Nicolai-Electronics/i2c-vfd-hardware/README.md

# I2C controlled HCS-12SS59T VFD

This repository contains the hardware desgin files for the I2C controlled NE-HCS12SS59T-R01 Vacuum Fluorescent Display board.

## License

Copyright 2024 Nicolai Electronics

This hardware design may be used under the terms of the [CERN-OHL-P](LICENSE) license.
