Nicolai-Electronics/i2c-vfd-hardware/release/schematic.pdf

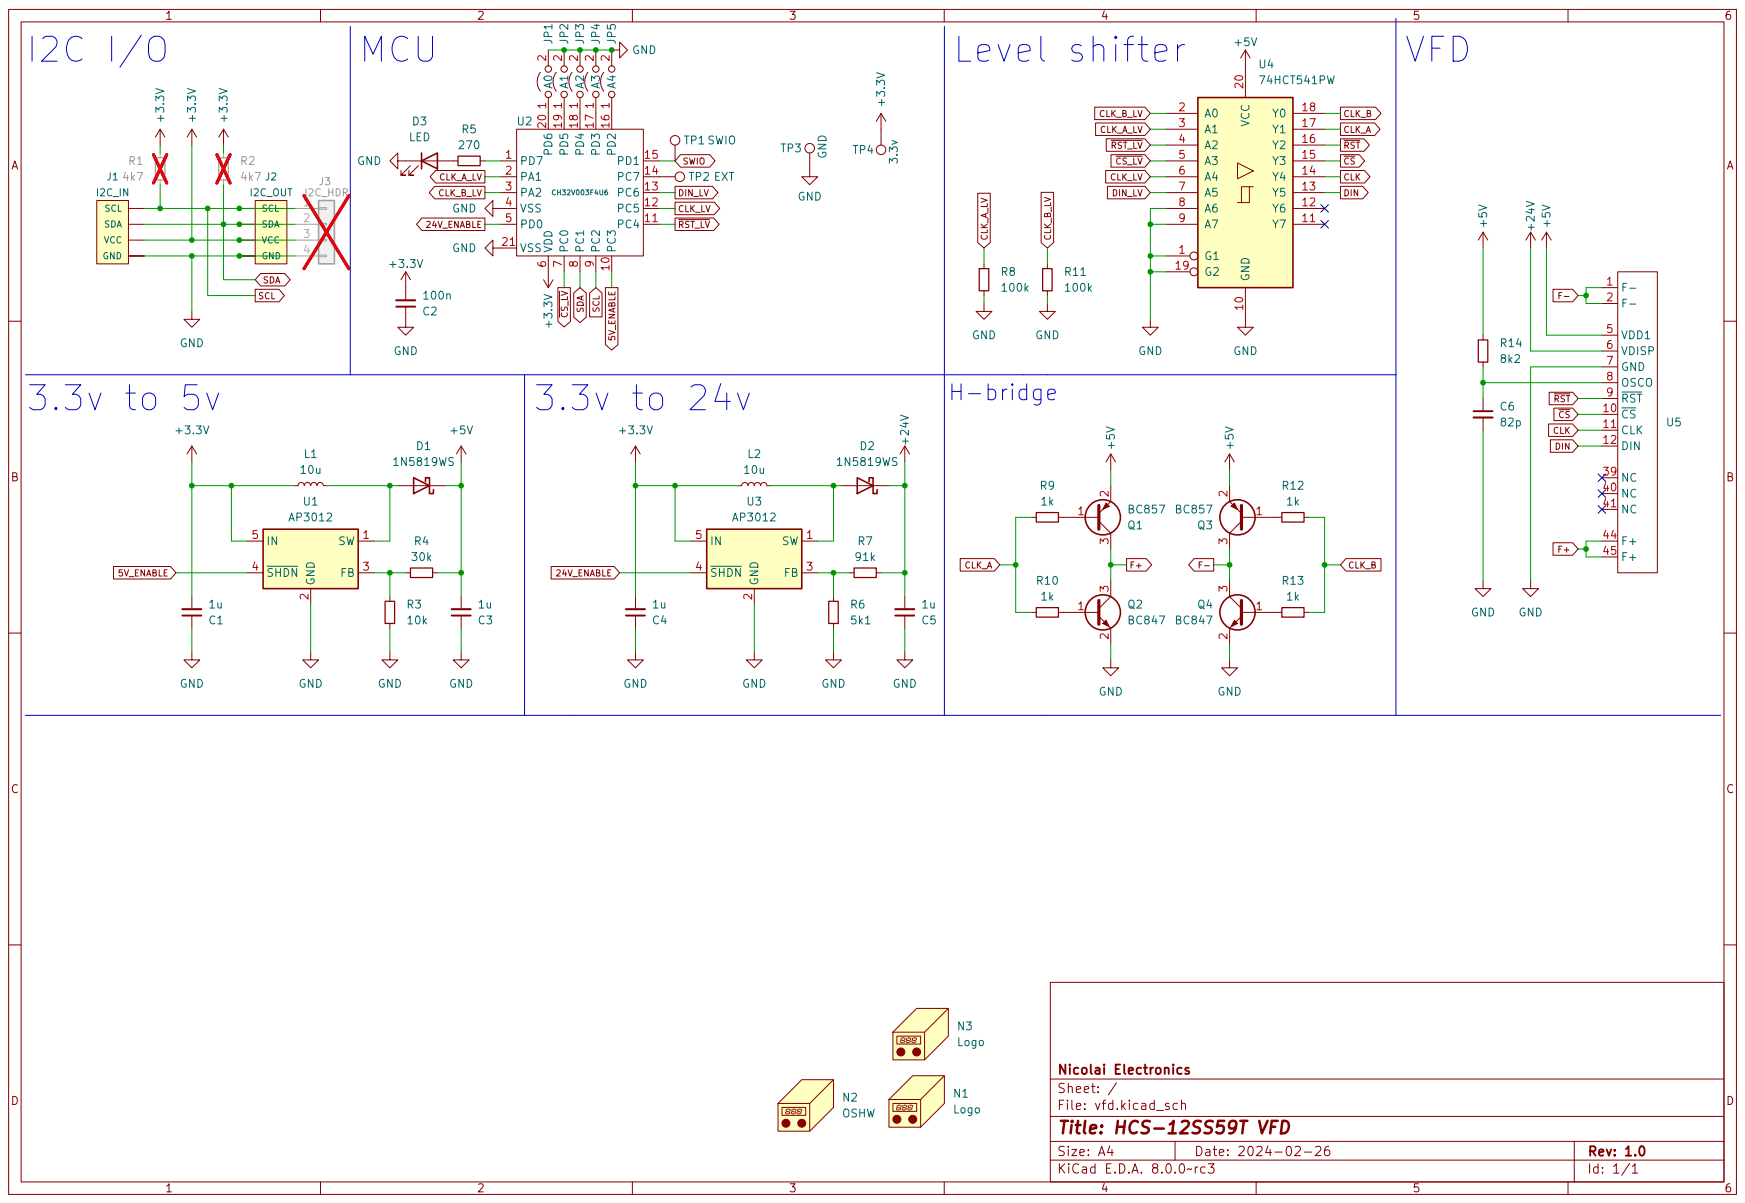
[picture p1: page 1]
