Nicolai-Electronics/i2c-vfd-hardware/vfd.kicad_pcb

## KiCad design vfd.kicad_pcb (2024-02-26)

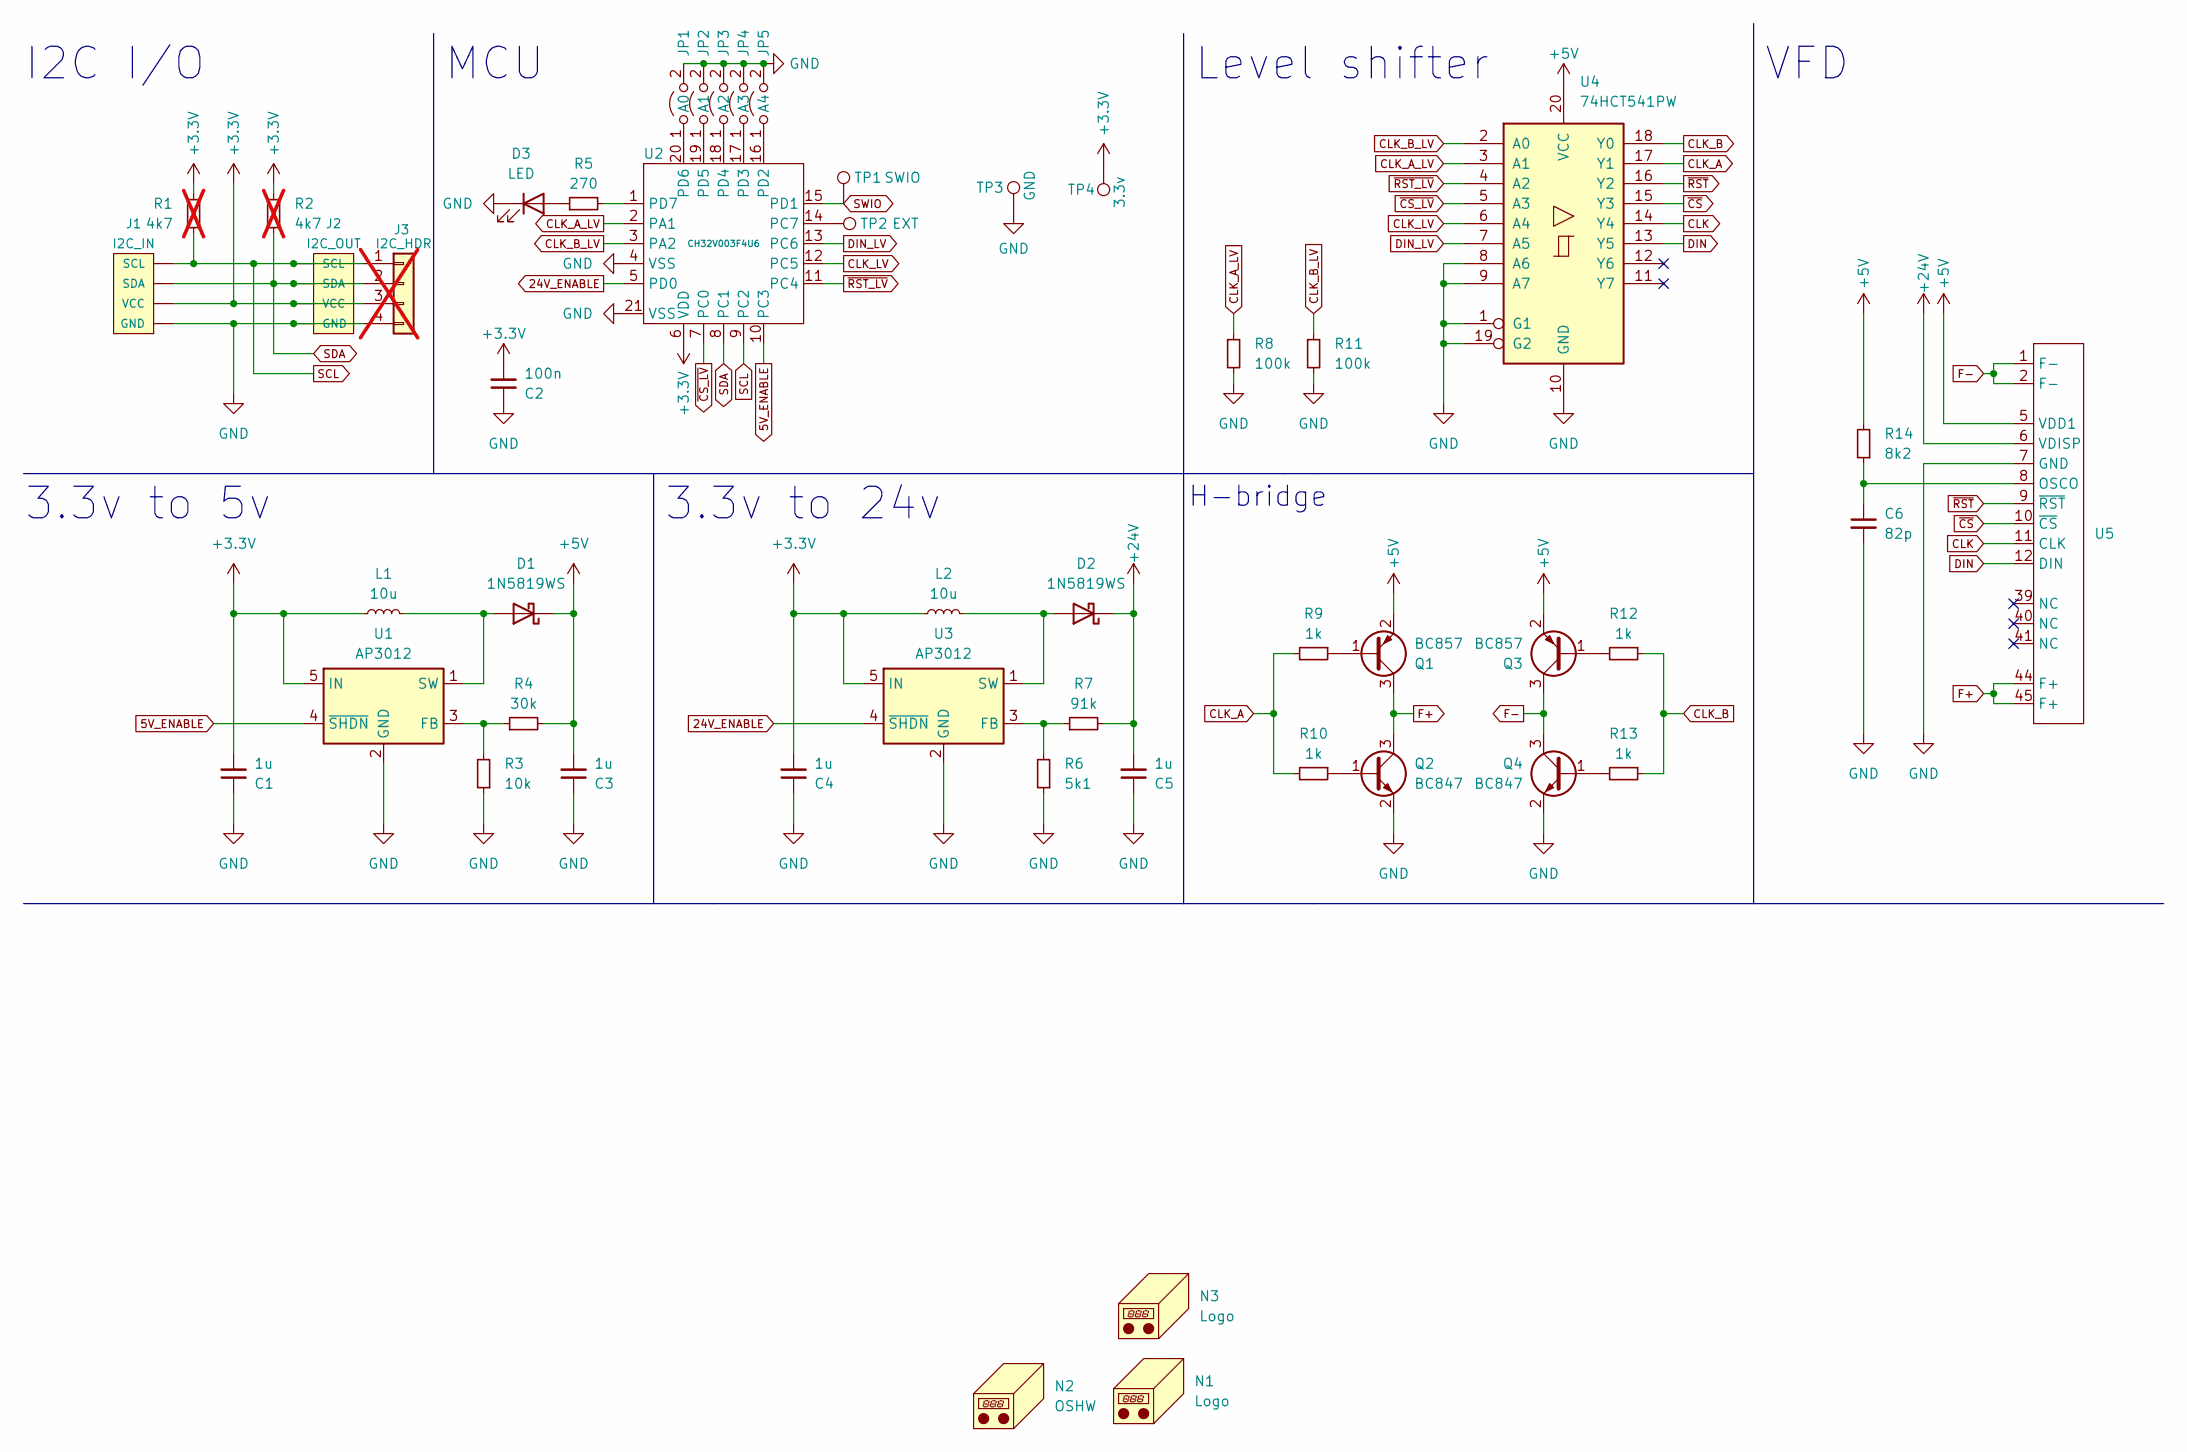
[picture p2: schematic vfd.kicad_sch, HCS-12SS59T VFD]

Parts:
C1, C3, C4, C5: 1u; C_0603_1608Metric; LCSC C1592
C2: 100n; C_0603_1608Metric; LCSC C282519
C6: 82p; C_0603_1608Metric; LCSC C1683
D1, D2: 1N5819WS; D_SOD-323; LCSC C191023
D3: LED; LED_0603_1608Metric; LCSC C264473
J1: I2C_IN; 1X04_1MM_RA_GND; LCSC C160404
J2: I2C_OUT; 1X04_1MM_RA_GND; LCSC C160404
J3: I2C_HDR; PinHeader_1x04_P2.54mm_Vertical; not fitted
JP1: A0; SolderJumper-2_P1.3mm_Open_TrianglePad1.0x1.5mm
JP2: A1; SolderJumper-2_P1.3mm_Open_TrianglePad1.0x1.5mm
JP3: A2; SolderJumper-2_P1.3mm_Open_TrianglePad1.0x1.5mm
JP4: A3; SolderJumper-2_P1.3mm_Open_TrianglePad1.0x1.5mm
JP5: A4; SolderJumper-2_P1.3mm_Open_TrianglePad1.0x1.5mm
L1, L2: 10u; Inductor_201610; LCSC C520204
N1, N3: Logo; logo_nicolai
N2: OSHW; OSHW-Logo_5.7x6mm_SilkScreen
Q1, Q3: BC857; SOT-23; LCSC C2139
Q2, Q4: BC847; SOT-23; LCSC C475630
R1, R2: 4k7; R_0603_1608Metric; not fitted
R3: 10k; R_0603_1608Metric; LCSC C25804
R4: 30k; R_0603_1608Metric; LCSC C22984
R5: 270; R_0603_1608Metric; LCSC C22966
R6: 5k1; R_0603_1608Metric; LCSC C23186
R7: 91k; R_0603_1608Metric; LCSC C23265
R8, R11: 100k; R_0603_1608Metric; LCSC C25803
R9, R10, R12, R13: 1k; R_0603_1608Metric; LCSC C21190
R14: 8k2; R_0603_1608Metric; LCSC C25981
TP1: SWIO; TestPoint_Pad_D1.5mm
TP2: EXT; TestPoint_Pad_D1.5mm
TP3: GND; TestPoint_Pad_D1.5mm
TP4: 3.3v; TestPoint_Pad_D1.5mm
U1, U3: AP3012; SOT-23-5; LCSC C102618
U2: CH32V003F4U6; QFN-20-1EP_3x3mm_P0.4mm_EP1.65x1.65mm; LCSC C5299908
U4: 74HCT541PW; TSSOP-20_4.4x6.5mm_P0.65mm; LCSC C131314
U5: HCS-12SS59T

Connections:
5V_ENABLE: U1.4 (~SHDN), U2.10 (PC3)
24V_ENABLE: U2.5 (PD0), U3.4 (~SHDN)
+3.3V: C1.2, C2.2, C4.2, J1.2 (VCC), J2.2 (VCC), J3.3, L1.1, L2.1, R1.2, R2.2, TP4.1, U1.5 (IN), U2.6 (VDD), U3.5 (IN)
+5V: C3.2, D1.1 (K), Q1.2 (E), Q3.2 (E), R4.2, R14.2, U4.20 (VCC), U5.5 (VDD1)
+24V: C5.2, D2.1 (K), R7.2, U5.6 (VDISP)
CLK: U4.14 (Y4), U5.11 (CLK)
CLK_A: R9.2, R10.2, U4.17 (Y1)
CLK_A_LV: R8.1, U2.2 (PA1), U4.3 (A1)
CLK_B: R12.1, R13.1, U4.18 (Y0)
CLK_B_LV: R11.1, U2.3 (PA2), U4.2 (A0)
CLK_LV: U2.12 (PC5), U4.6 (A4)
DIN: U4.13 (Y5), U5.12 (DIN)
DIN_LV: U2.13 (PC6), U4.7 (A5)
F+: Q1.3 (C), Q2.3 (C), U5.44 (F+), U5.45 (F+)
F-: Q3.3 (C), Q4.3 (C), U5.1 (F-), U5.2 (F-)
GND: C1.1, C2.1, C3.1, C4.1, C5.1, C6.2, D3.1 (K), J1.1 (GND), J1.5, J1.6, J2.1 (GND), J2.5, J2.6, J3.4, JP1.2 (B), JP2.2 (B), JP3.2 (B), JP4.2 (B), JP5.2 (B), Q2.2 (E), Q4.2 (E), R3.1, R6.1, R8.2, R11.2, TP3.1, U1.2 (GND), U2.4 (VSS), U2.21 (VSS), U3.2 (GND), U4.1 (G1), U4.8 (A6), U4.9 (A7), U4.10 (GND), U4.19 (G2), U5.7 (GND)
unnamed: D1.2 (A), L1.2, U1.1 (SW)
unnamed: D2.2 (A), L2.2, U3.1 (SW)
unnamed: D3.2 (A), R5.1
unnamed: JP1.1 (A), U2.20 (PD6)
unnamed: JP2.1 (A), U2.19 (PD5)
unnamed: JP3.1 (A), U2.18 (PD4)
unnamed: JP4.1 (A), U2.17 (PD3)
unnamed: JP5.1 (A), U2.16 (PD2)
unnamed: Q1.1 (B), R9.1
unnamed: Q2.1 (B), R10.1
unnamed: Q3.1 (B), R12.2
unnamed: Q4.1 (B), R13.2
unnamed: R3.2, R4.1, U1.3 (FB)
unnamed: TP2.1, U2.14 (PC7)
unnamed: R5.2, U2.1 (PD7)
unnamed: R6.2, R7.1, U3.3 (FB)
unnamed: C6.1, R14.1, U5.8 (OSCO)
SCL: J1.4 (SCL), J2.4 (SCL), J3.1, R1.1, U2.9 (PC2)
SDA: J1.3 (SDA), J2.3 (SDA), J3.2, R2.1, U2.8 (PC1)
SWIO: TP1.1, U2.15 (PD1)
~CS_LV: U2.7 (PC0), U4.5 (A3)
~CS: U4.15 (Y3), U5.10 (~CS)
~RST_LV: U2.11 (PC4), U4.4 (A2)
~RST: U4.16 (Y2), U5.9 (~RST)

Notes on the sheet:
3.3v to 5v
H-bridge
3.3v to 24v
MCU
I2C I/O
VFD
Level shifter

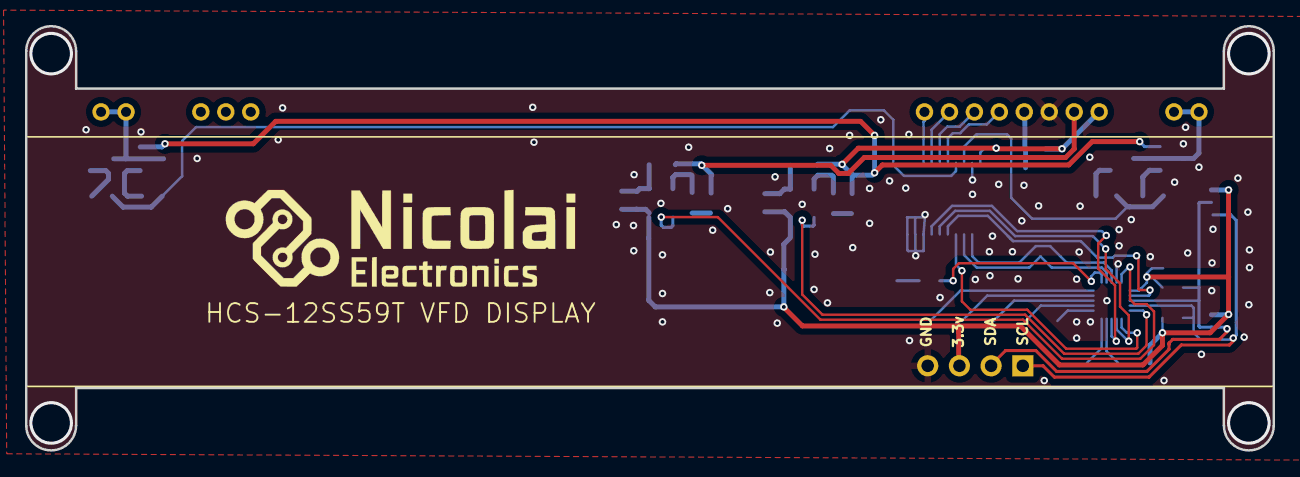
[picture p3: board vfd.kicad_pcb from above]

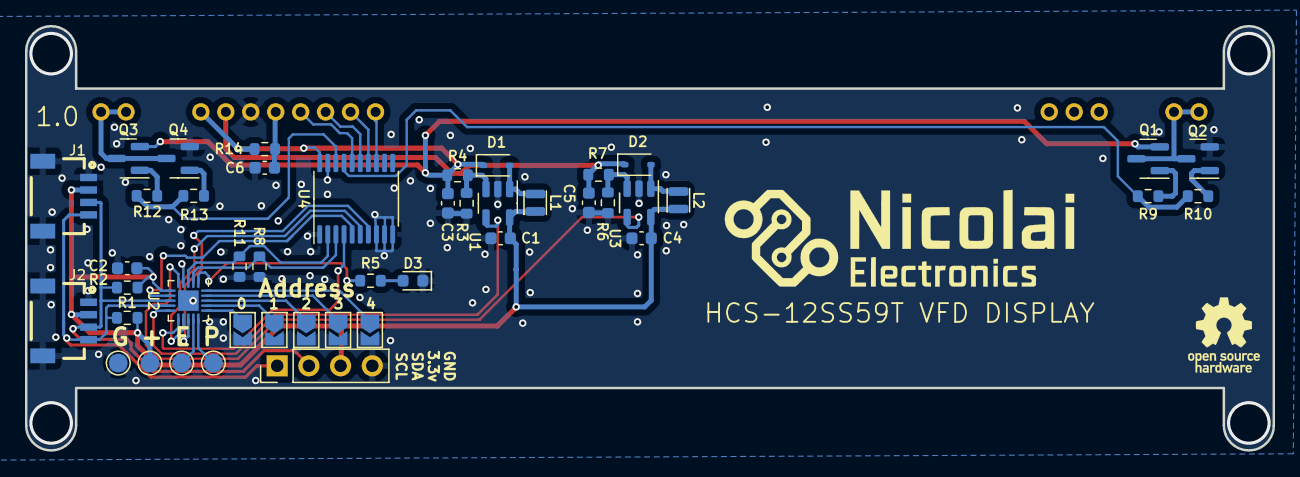
[picture p4: board vfd.kicad_pcb from below]

Board: 2 copper layers, 100.0 x 34.0 mm, 49 parts (47 on the bottom side), 40 nets.
