Nicolai-Electronics/i2c-vfd-hardware/(commit log)

2023-09-20 Version 0.2 final
    [vfd.kicad_pcb, vfd.kicad_sch]
2023-09-20 Add PDF schematic
2024-01-23 Make inductor pads bigger, make vfd pads and holes larger
    [vfd.kicad_pcb, vfd.kicad_sch]
2024-02-26 Revision 1.0 final
    [vfd.kicad_pcb, vfd.kicad_sch]
2024-02-26 Remove old schematic pdf
